gkoolstra/jpa_cancellation_pid_controller/circuit_schematic.png

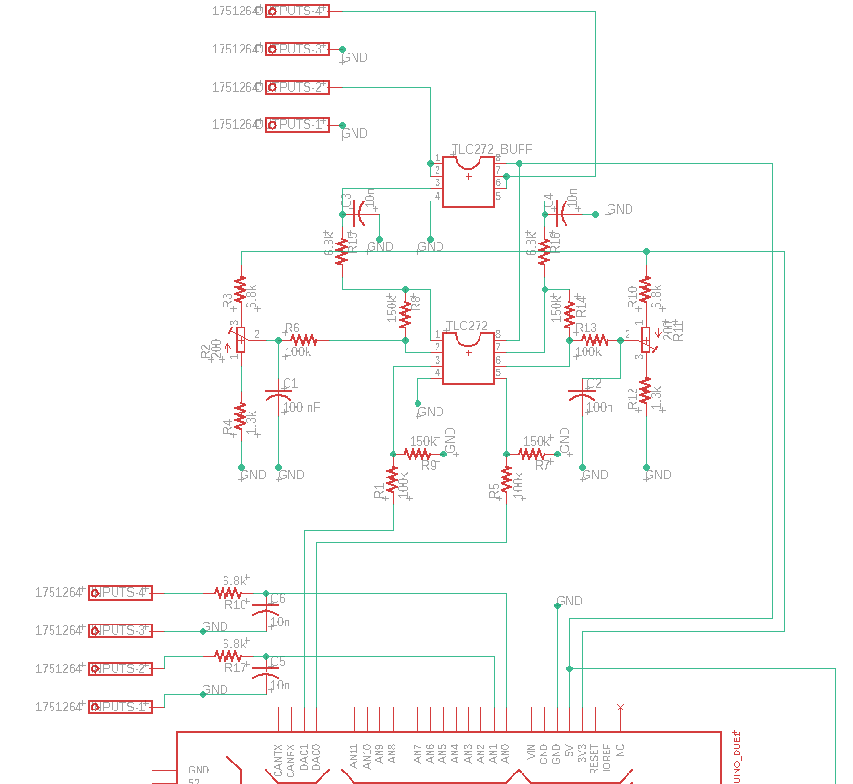
circuit_schematic.png
