gkoolstra/jpa_cancellation_pid_controller/settling_time.png

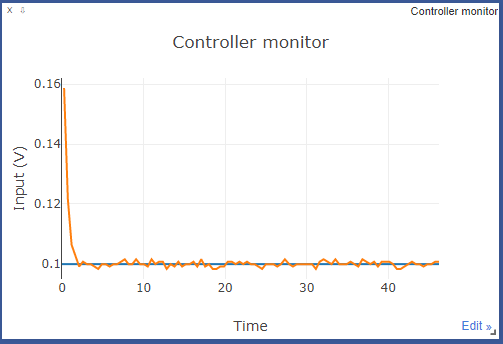
settling_time.png
