gkoolstra/jpa_cancellation_pid_controller/(commit log)

2020-07-20 Add Arduino code and python code
2020-07-20 First commit of jupyter notebook for pid controller
